2B-Tobe/rc-rf-module/docs/README.md

# Documentation

| File | |
|---|---|
| `QUICK_SHEET_EFR32_Module.md` | how to operate the module: connections, roles, modes, setup, bind, failsafe, LEDs, log |
| `SERIAL_INPUT.md` | what a transmitter sends (PPM, the Multiprotocol serial frame, the failsafe frame) and the `cfg` setup commands any programmer can use |
| `RLINK.md` | the RLINK two-way link |
| `../controller/docs/MANUAL.md`, `QUICK_SHEET.md`, `CUBEIDE.md` | the Controller box |
| `../firmware/README.md` | building and flashing the firmware |
| `../hardware/` | the boards |
