2B-Tobe/rc-rf-module/hardware/controller/rc-rf-controller.pdf

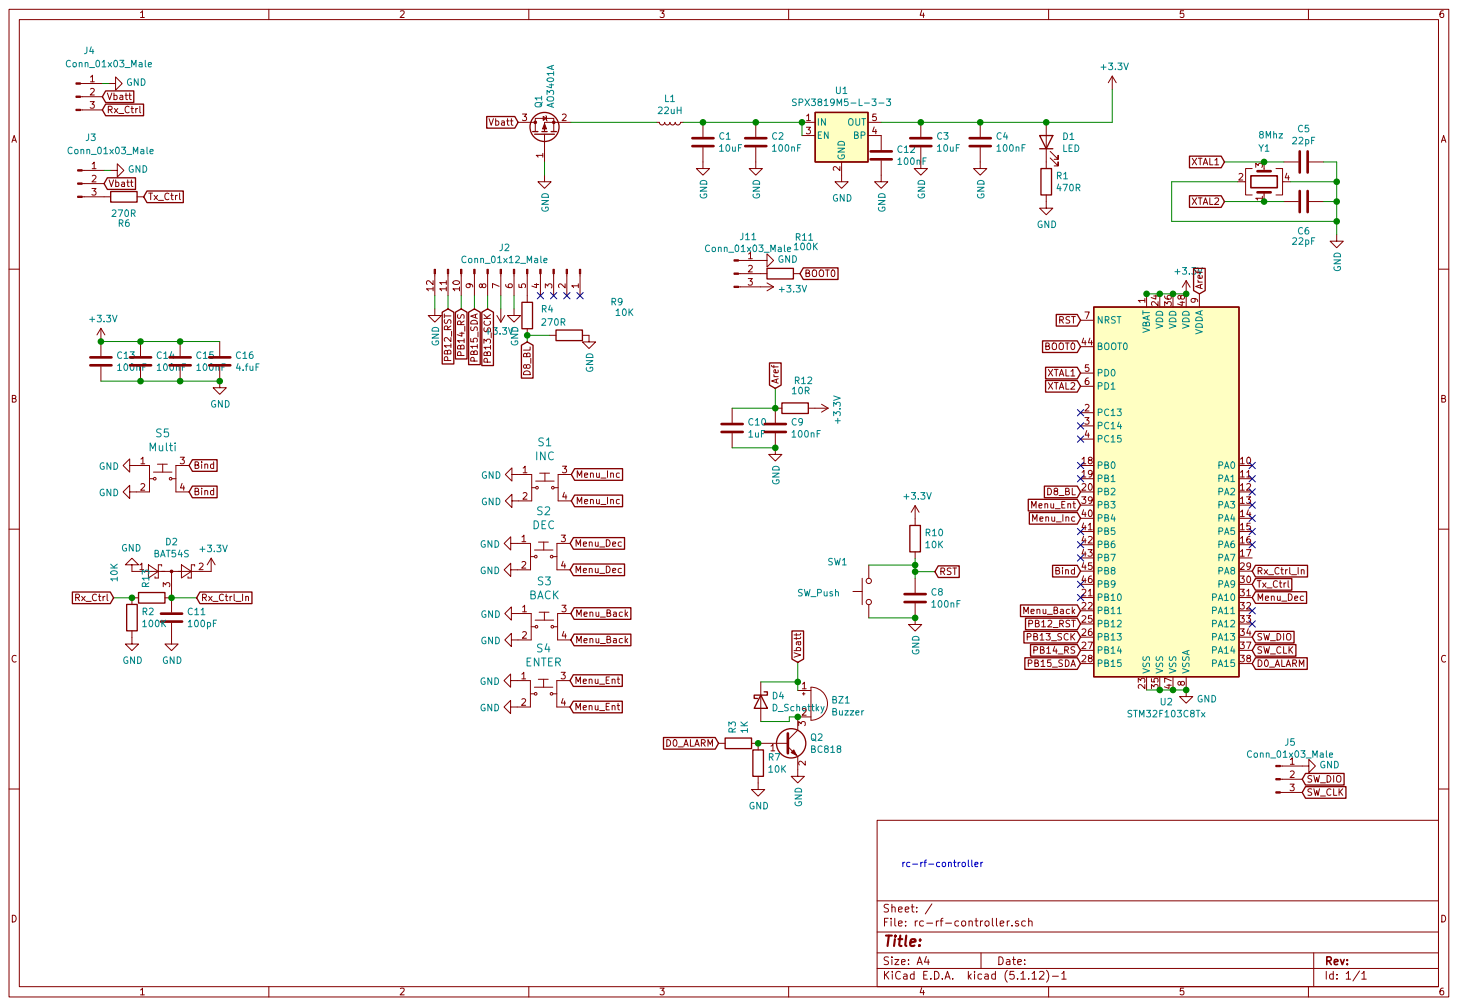
[picture p1: page 1]
