2B-Tobe/rc-rf-module/hardware/rf_module/Multi_Mode.pdf

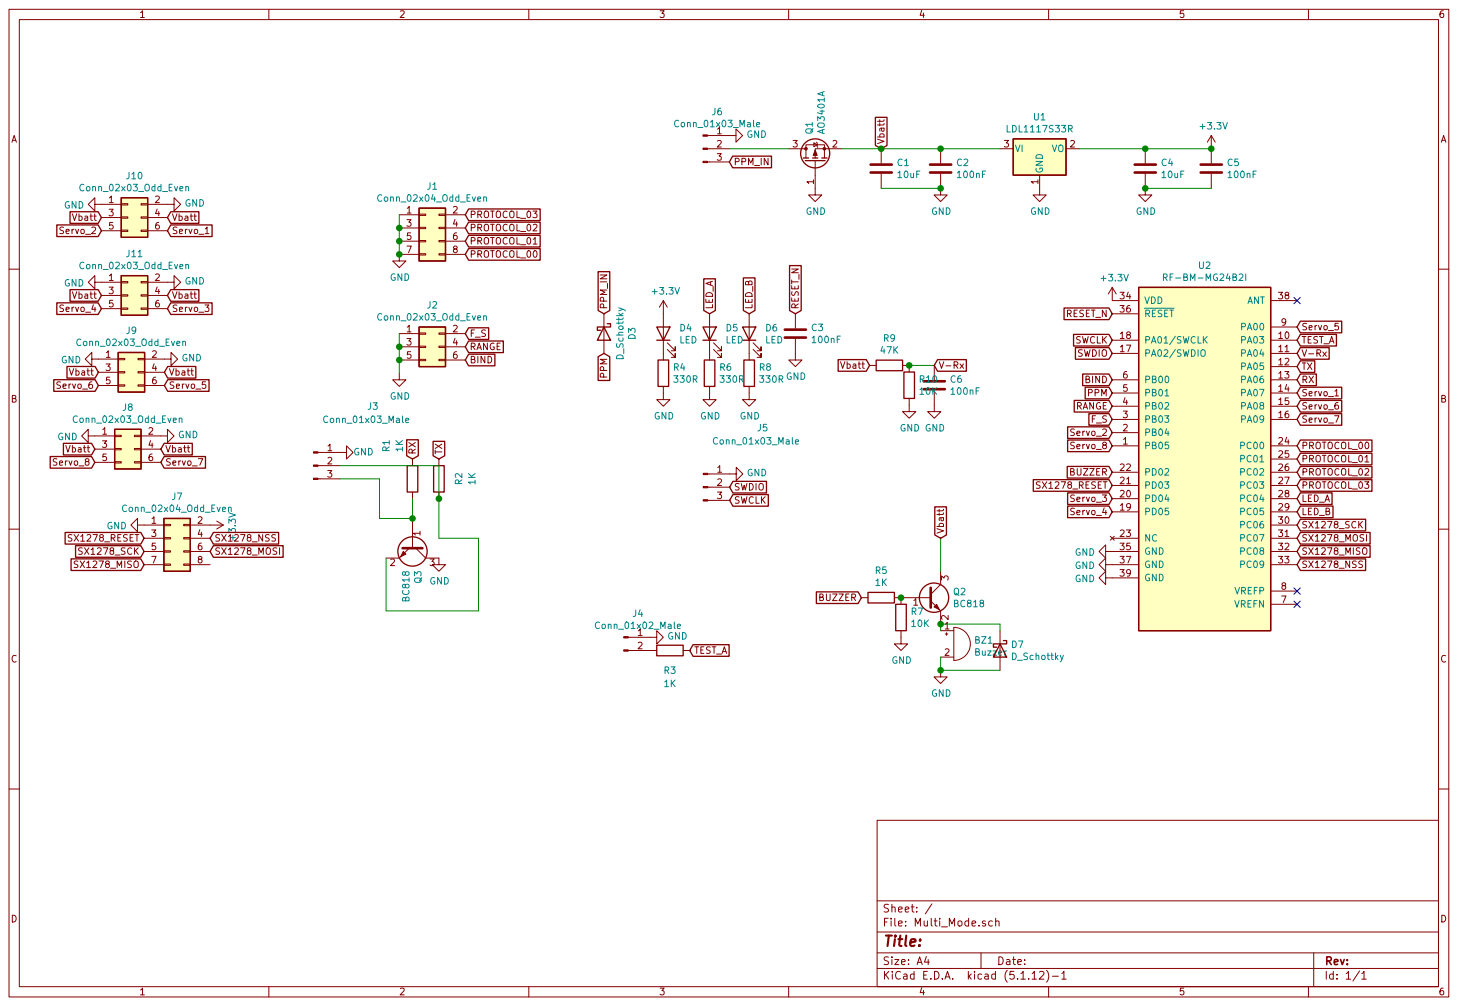
[picture p2: page 1]
