2B-Tobe/rc-rf-module/hardware/rf_module/kicad/Multi_Mode.kicad_pcb

## KiCad design hardware/rf_module/kicad/Multi_Mode.kicad_pcb (2026-11-09)

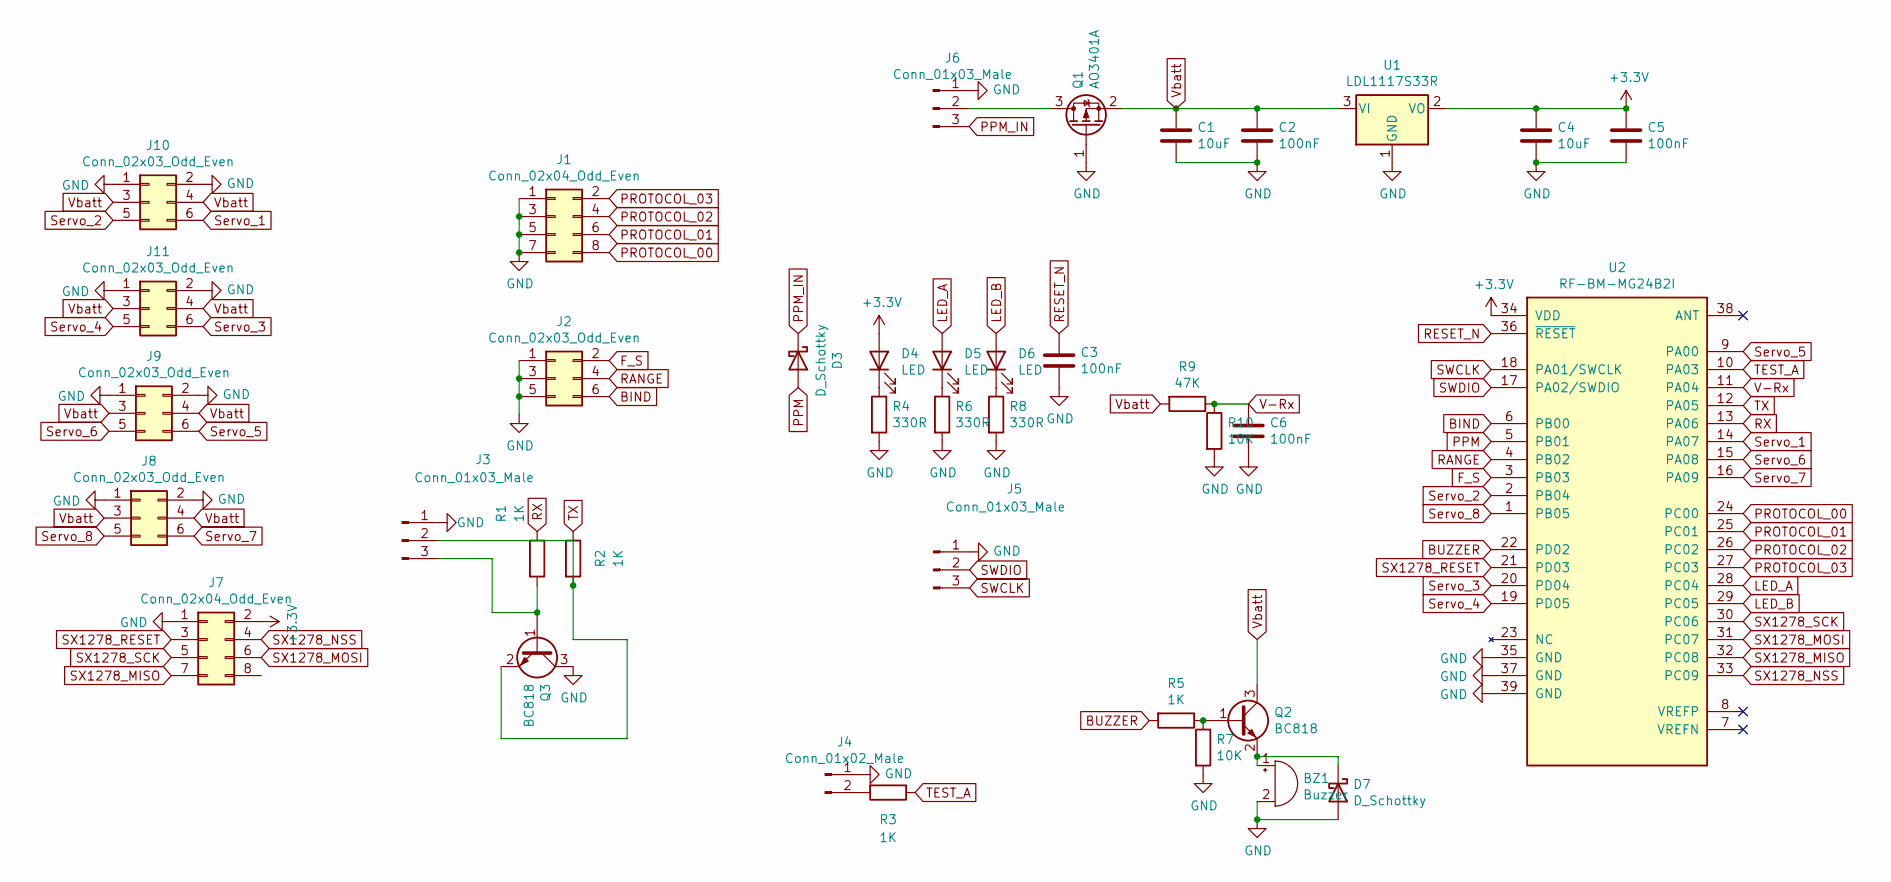
[picture p3: schematic Multi_Mode.sch]

Parts:
BZ1: Buzzer; CUI_CSS-0578-SMT
C1, C4: 10uF; C_0805_2012Metric
C2, C3, C5, C6: 100nF; C_0603_1608Metric
D3, D7: D_Schottky; D_SOD-323
D4, D5, D6: LED; LED_0603_1608Metric
J1, J7: Conn_02x04_Odd_Even; PinHeader_2x04_P2.54mm_Vertical
J2, J8, J9, J10, J11: Conn_02x03_Odd_Even; PinHeader_2x03_P2.54mm_Vertical
J3, J5, J6: Conn_01x03_Male; PinHeader_1x03_P2.54mm_Vertical
J4: Conn_01x02_Male; PinHeader_1x02_P2.54mm_Vertical
Q1: AO3401A; SOT-23
Q2, Q3: BC818; SOT-23
R1, R2, R3, R5: 1K; R_0603_1608Metric
R4, R6, R8: 330R; R_0603_1608Metric
R7, R10: 10K; R_0603_1608Metric
R9: 47K; R_0603_1608Metric
U1: LDL1117S33R; SOT-223-3_TabPin2
U2: RF-BM-MG24B2I

Connections:
+3V3: C4.1, C5.1, D4.2 (A), J7.2, U1.2 (VO), U2.34 (VDD)
BIND: J2.6, U2.6 (PB00)
BUZZER: R5.2, U2.22 (PD02)
F_S: J2.2, U2.3 (PB03)
GND: BZ1.2 (+), C1.2, C2.2, C3.2, C4.2, C5.2, C6.2, D7.2 (A), J1.1, J1.3, J1.5, J1.7, J2.1, J2.3, J2.5, J3.1, J4.1, J5.1, J6.1, J7.1, J8.1, J8.2, J9.1, J9.2, J10.1, J10.2, J11.1, J11.2, Q1.1 (G), Q3.3 (C), R4.2, R6.2, R7.2, R8.2, R10.2, U1.1 (GND), U2.35 (GND), U2.37 (GND), U2.39 (GND)
LED_A: D5.2 (A), U2.28 (PC04)
LED_B: D6.2 (A), U2.29 (PC05)
unnamed: BZ1.1 (-), D7.1 (K), Q2.2 (E)
unnamed: D4.1 (K), R4.1
unnamed: D5.1 (K), R6.1
unnamed: D6.1 (K), R8.1
unnamed: J3.2, Q3.2 (E), R2.2
unnamed: J3.3, Q3.1 (B), R1.2
unnamed: J4.2, R3.2
unnamed: J6.2, Q1.3 (D)
unnamed: Q2.1 (B), R5.1, R7.1
PPM: D3.2 (A), U2.5 (PB01)
PPM_IN: D3.1 (K), J6.3
PROTOCOL_00: J1.8, U2.24 (PC00)
PROTOCOL_01: J1.6, U2.25 (PC01)
PROTOCOL_02: J1.4, U2.26 (PC02)
PROTOCOL_03: J1.2, U2.27 (PC03)
RANGE: J2.4, U2.4 (PB02)
RESET_N: C3.1, U2.36 (~RESET)
RX: R1.1, U2.13 (PA06)
SWCLK: J5.3, U2.18 (PA01/SWCLK)
SWDIO: J5.2, U2.17 (PA02/SWDIO)
SX1278_MISO: J7.7, U2.32 (PC08)
SX1278_MOSI: J7.6, U2.31 (PC07)
SX1278_NSS: J7.4, U2.33 (PC09)
SX1278_RESET: J7.3, U2.21 (PD03)
SX1278_SCK: J7.5, U2.30 (PC06)
Servo_1: J10.6, U2.14 (PA07)
Servo_2: J10.5, U2.2 (PB04)
Servo_3: J11.6, U2.20 (PD04)
Servo_4: J11.5, U2.19 (PD05)
Servo_5: J9.6, U2.9 (PA00)
Servo_6: J9.5, U2.15 (PA08)
Servo_7: J8.6, U2.16 (PA09)
Servo_8: J8.5, U2.1 (PB05)
TEST_A: R3.1, U2.10 (PA03)
TX: R2.1, U2.12 (PA05)
V-Rx: C6.1, R9.1, R10.1, U2.11 (PA04)
Vbatt: C1.1, C2.1, J8.3, J8.4, J9.3, J9.4, J10.3, J10.4, J11.3, J11.4, Q1.2 (S), Q2.3 (C), R9.2, U1.3 (VI)

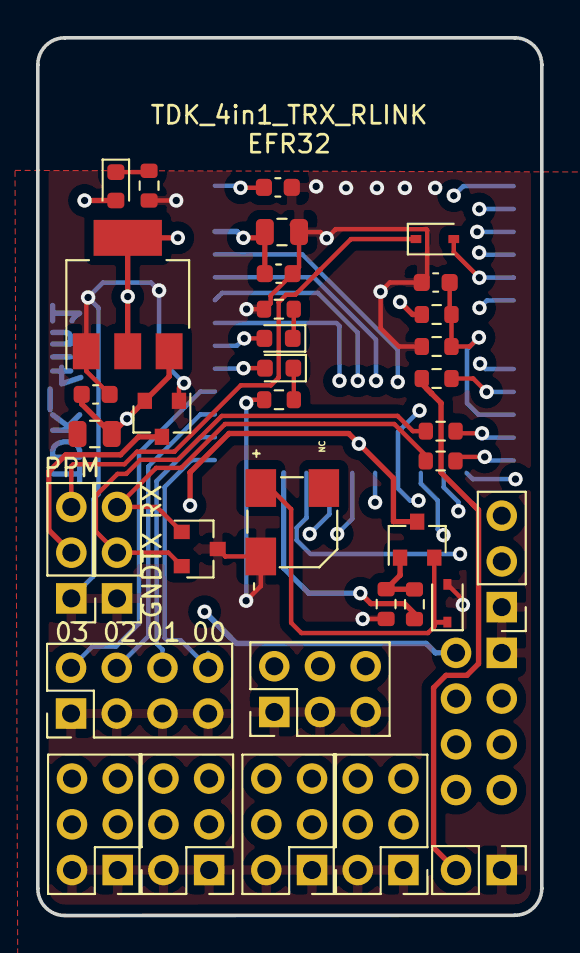
[picture p4: board Multi_Mode.kicad_pcb from above]

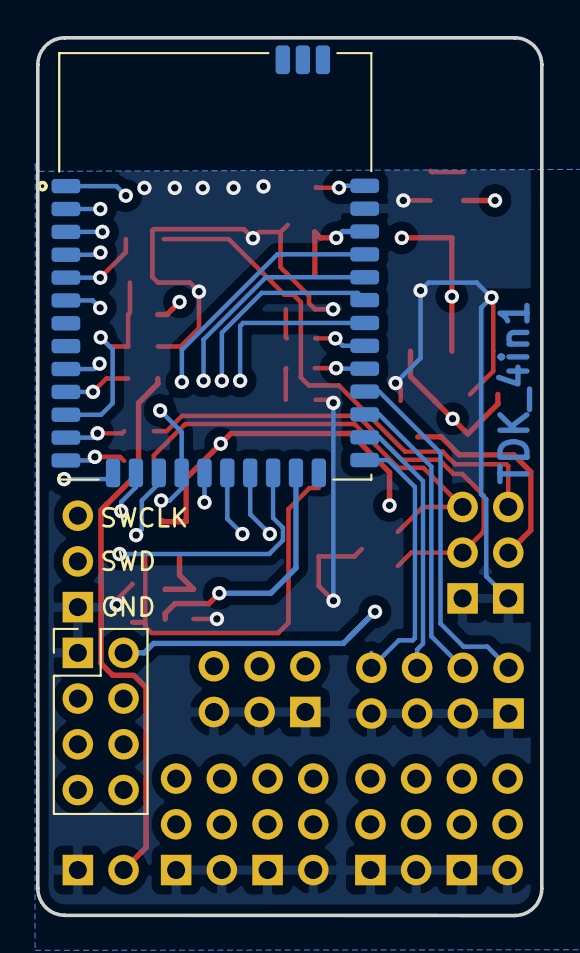
[picture p5: board Multi_Mode.kicad_pcb from below]

Board: 4 copper layers, 28.0 x 48.8 mm, 38 parts (2 on the bottom side), 44 nets.
