2B-Tobe/rc-rf-module/hardware/controller/kicad/rc-rf-controller.kicad_pcb

## KiCad design hardware/controller/kicad/rc-rf-controller.kicad_pcb (2026-11-09)

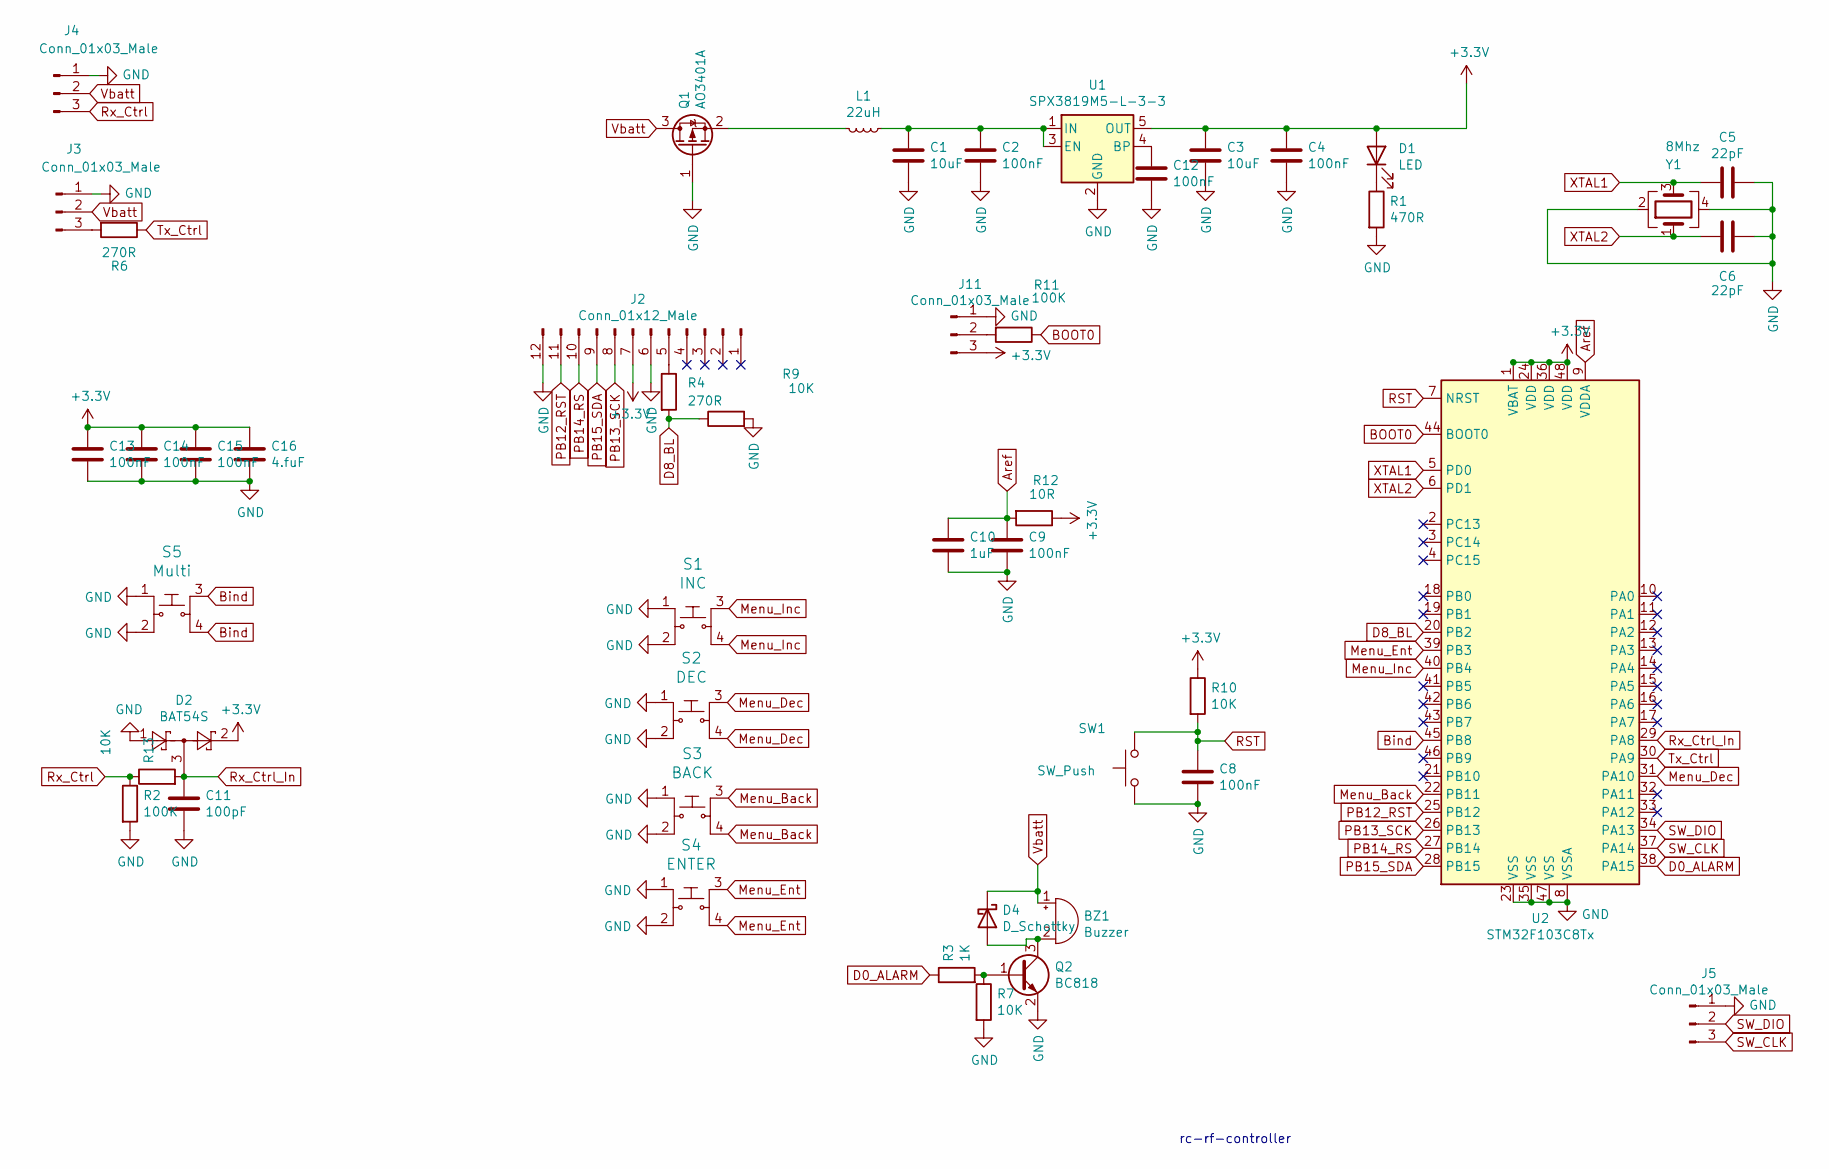
[picture p6: schematic rc-rf-controller.sch]

Parts:
BZ1: Buzzer; CUI_CSS-0578-SMT
C1, C3: 10uF; C_0805_2012Metric
C2, C4, C8, C9, C12, C13, C14, C15: 100nF; C_0603_1608Metric
C5, C6: 22pF; C_0603_1608Metric
C10: 1uF; C_0603_1608Metric
C11: 100pF; C_0603_1608Metric
C16: 4.fuF; C_0603_1608Metric
D1: LED; LED_0603_1608Metric
D2: BAT54S; SOT-23
D4: D_Schottky; D_SOD-323
J2: Conn_01x12_Male; PinHeader_1x12_P2.54mm_Vertical
J3, J4, J5: Conn_01x03_Male; PinHeader_1x03_P2.54mm_Vertical
J11: Conn_01x03_Male; SolderJumper-3_P1.3mm_Open_Pad1.0x1.5mm
L1: 22uH; Inductor_6060_MK
Q1: AO3401A; SOT-23
Q2: BC818; SOT-23
R1: 470R; R_0603_1608Metric
R2, R11: 100K; R_0603_1608Metric
R3: 1K; R_0603_1608Metric
R4, R6: 270R; R_0603_1608Metric
R7, R9, R10, R13: 10K; R_0603_1608Metric
R12: 10R; R_0603_1608Metric
S1: INC; SW_1825910-7; MPN 1825910-6; Digi-Key_PN 450-1650-ND
S2: DEC; SW_1825910-7; MPN 1825910-6; Digi-Key_PN 450-1650-ND
S3: BACK; SW_1825910-7; MPN 1825910-6; Digi-Key_PN 450-1650-ND
S4: ENTER; SW_1825910-7; MPN 1825910-6; Digi-Key_PN 450-1650-ND
S5: Multi; SW_1825910-7; MPN 1825910-6; Digi-Key_PN 450-1650-ND
SW1: SW_Push; SW_SPST_B3U-1000P
U1: SPX3819M5-L-3-3; SOT-23-5
U2: STM32F103C8Tx; LQFP-48_7x7mm_P0.5mm
Y1: 8Mhz; Crystal_SMD_3225-4Pin_3.2x2.5mm

Connections:
+3V3: C3.1, C4.1, C13.1, C14.1, C15.1, C16.1, D1.2 (A), D2.2, J2.7, J11.3, R10.1, R12.1, U1.5 (OUT), U2.1 (VBAT), U2.24 (VDD), U2.36 (VDD), U2.48 (VDD)
Aref: C9.1, C10.1, R12.2, U2.9 (VDDA)
BOOT0: R11.1, U2.44 (BOOT0)
Bind: S5.3, S5.4, U2.45 (PB8)
D0_ALARM: R3.1, U2.38 (PA15)
D8_BL: R4.2, R9.1, U2.20 (PB2)
GND: C1.2, C2.2, C3.2, C4.2, C5.1, C6.1, C8.2, C9.2, C10.2, C11.2, C12.2, C13.2, C14.2, C15.2, C16.2, D2.1, J2.6, J2.12, J3.1, J4.1, J5.1, J11.1, Q1.1 (G), Q2.2 (E), R1.2, R2.2, R7.2, R9.2, S1.1, S1.2, S2.1, S2.2, S3.1, S3.2, S4.1, S4.2, S5.1, S5.2, SW1.1, U1.2 (GND), U2.8 (VSSA), U2.23 (VSS), U2.35 (VSS), U2.47 (VSS), Y1.2, Y1.4
Menu_Back: S3.3, S3.4, U2.22 (PB11)
Menu_Dec: S2.3, S2.4, U2.31 (PA10)
Menu_Ent: S4.3, S4.4, U2.39 (PB3)
Menu_Inc: S1.3, S1.4, U2.40 (PB4)
unnamed: BZ1.2 (+), D4.2 (A), Q2.3 (C)
unnamed: C1.1, C2.1, L1.1, U1.1 (IN), U1.3 (EN)
unnamed: C12.1, U1.4 (BP)
unnamed: D1.1 (K), R1.1
unnamed: J2.5, R4.1
unnamed: J3.3, R6.2
unnamed: J11.2, R11.2
unnamed: L1.2, Q1.2 (S)
unnamed: Q2.1 (B), R3.2, R7.1
PB12_RST: J2.11, U2.25 (PB12)
PB13_SCK: J2.8, U2.26 (PB13)
PB14_RS: J2.10, U2.27 (PB14)
PB15_SDA: J2.9, U2.28 (PB15)
RST: C8.1, R10.2, SW1.2, U2.7 (NRST)
Rx_Ctrl: J4.3, R2.1, R13.1
Rx_Ctrl_In: C11.1, D2.3, R13.2, U2.29 (PA8)
SW_CLK: J5.3, U2.37 (PA14)
SW_DIO: J5.2, U2.34 (PA13)
Tx_Ctrl: R6.1, U2.30 (PA9)
Vbatt: BZ1.1 (-), D4.1 (K), J3.2, J4.2, Q1.3 (D)
XTAL1: C5.2, U2.5 (PD0), Y1.3
XTAL2: C6.2, U2.6 (PD1), Y1.1

Notes on the sheet:
rc-rf-controller

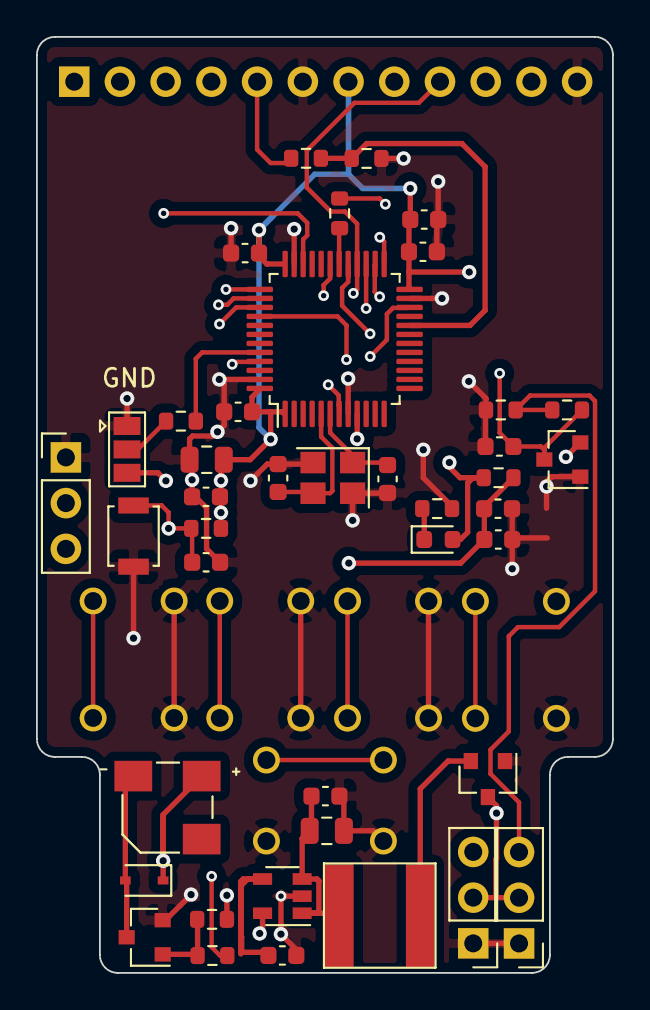
[picture p7: board rc-rf-controller.kicad_pcb from above]

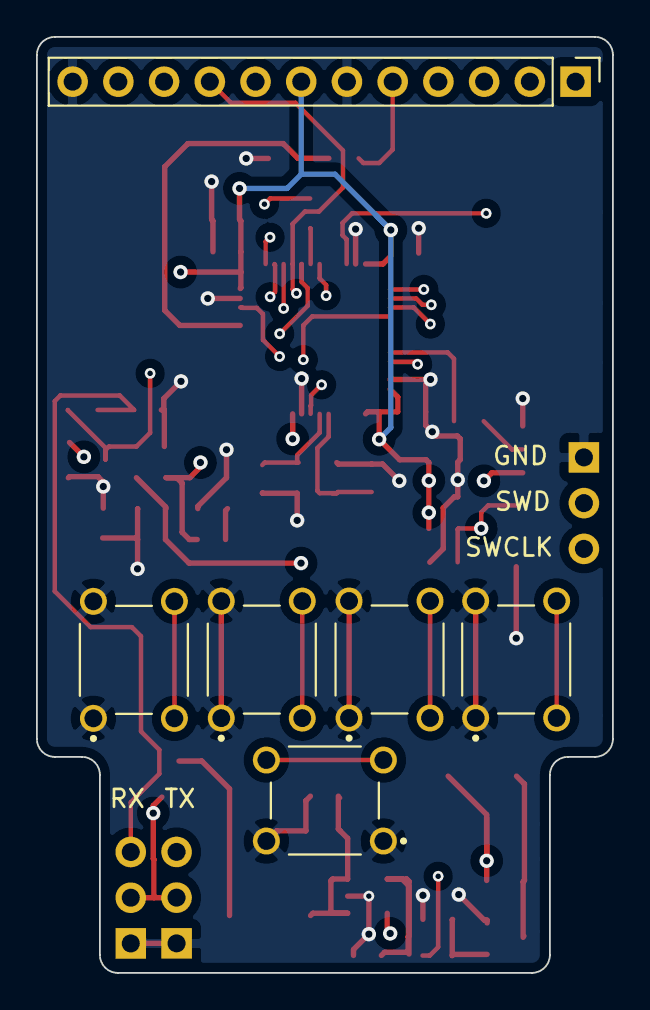
[picture p8: board rc-rf-controller.kicad_pcb from below]

Board: 4 copper layers, 32.0 x 52.0 mm, 47 parts (6 on the bottom side), 33 nets.
