2B-Tobe/rc-rf-module/(commit log)

2026-11-09 RC RF Module: EFR32 module firmware 1.4 and RF Module Controller 1.3
    - the module as a MULTI (4-in-1) module in an EdgeTX radio: Multiprotocol
    protocol numbers, MiTo (120) for RLINK / nRF24 / UK459, status, protocol
    list and telemetry
    - the same board and firmware as transmitter module or receiver; receiver
    outputs 8 PWM or 5 PWM + SBUS / PPM; receiver setup over the air
    - RLINK, nRF24, FrSky D8 / D16, DSMX; optional 459 MHz second band
    - serial frames or PPM input; setup stored with the controller box
    - hardware files for both boards, documentation, credits
    [Multi_Mode-B_Cu.gbr, Multi_Mode-B_Mask.gbr, Multi_Mode-B_Paste.gbr, Multi_Mode-B_SilkS.gbr, Multi_Mode-Edge_Cuts.gbr, Multi_Mode-F_Cu.gbr, Multi_Mode-F_Mask.gbr, Multi_Mode-F_Paste.gbr]
2026-11-09 Firmware 1.4: a board stored as a receiver runs as the transmitter module in a radio bay
2026-11-09 Firmware 1.4: back out the radio-bay check for boards stored as a receiver (it broke the status after a bind in EdgeTX); store such a board as a transmitter
    [app_process.c]
2026-11-10 Licence: Silicon Labs MSLA files no longer in the repository (build.ps1 copies them from the installed SDK); GPLv3 section 7 permission for building with RAIL
2026-11-10 Licence notes: the RAIL library is Zlib per the SDK's License.txt (still not in the repository); the printf files stay MSLA
2026-11-10 LICENSE: section 7 permission names the RAIL library as Zlib (binary only) and the MSLA parts separately; line wrapping
2026-11-10 Firmware 1.4: a board stored as a receiver, in an EdgeTX radio bay, stores the transmitter setup and restarts as the transmitter module (bench-tested on the X7)
